microresearch/WORM/README.md

The WORM was for a long time desirous to speake, but the rule and
or∣der of the Court enjoyned him silence, but now strutting and
swelling, and impatient, of further delay, he broke out thus... [Maier]
