microresearch/WORM/worm001_revised_reducing003-SilkS_Front.pdf

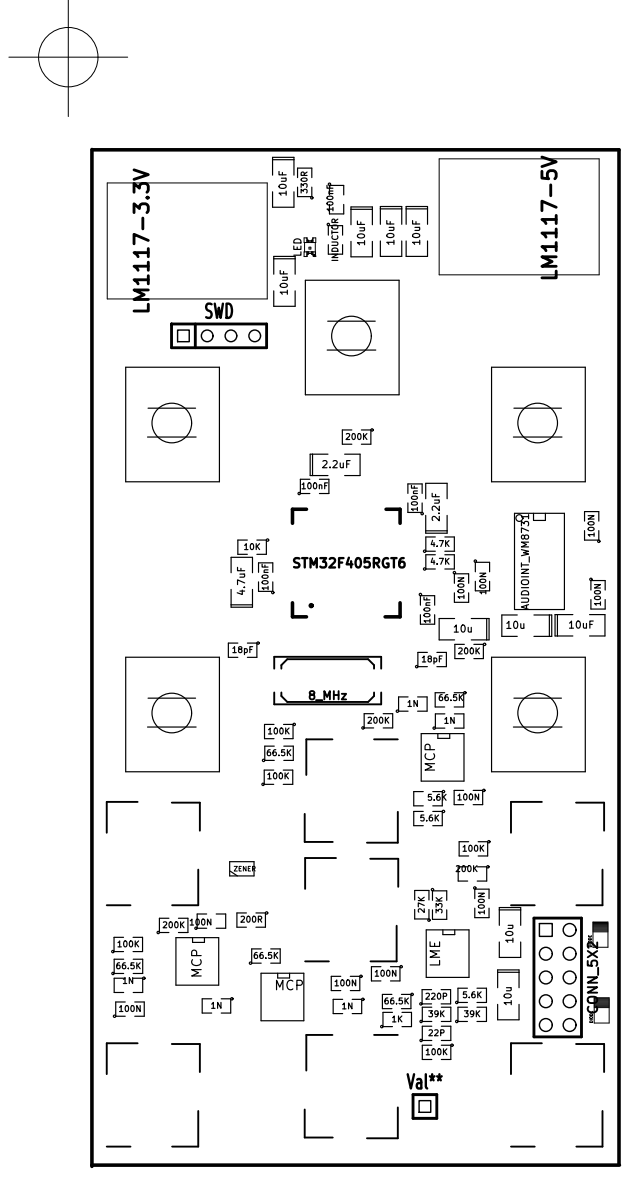
[picture p1: page 1]
