microresearch/WORM/worm001-Sheet550B4EA0.pdf

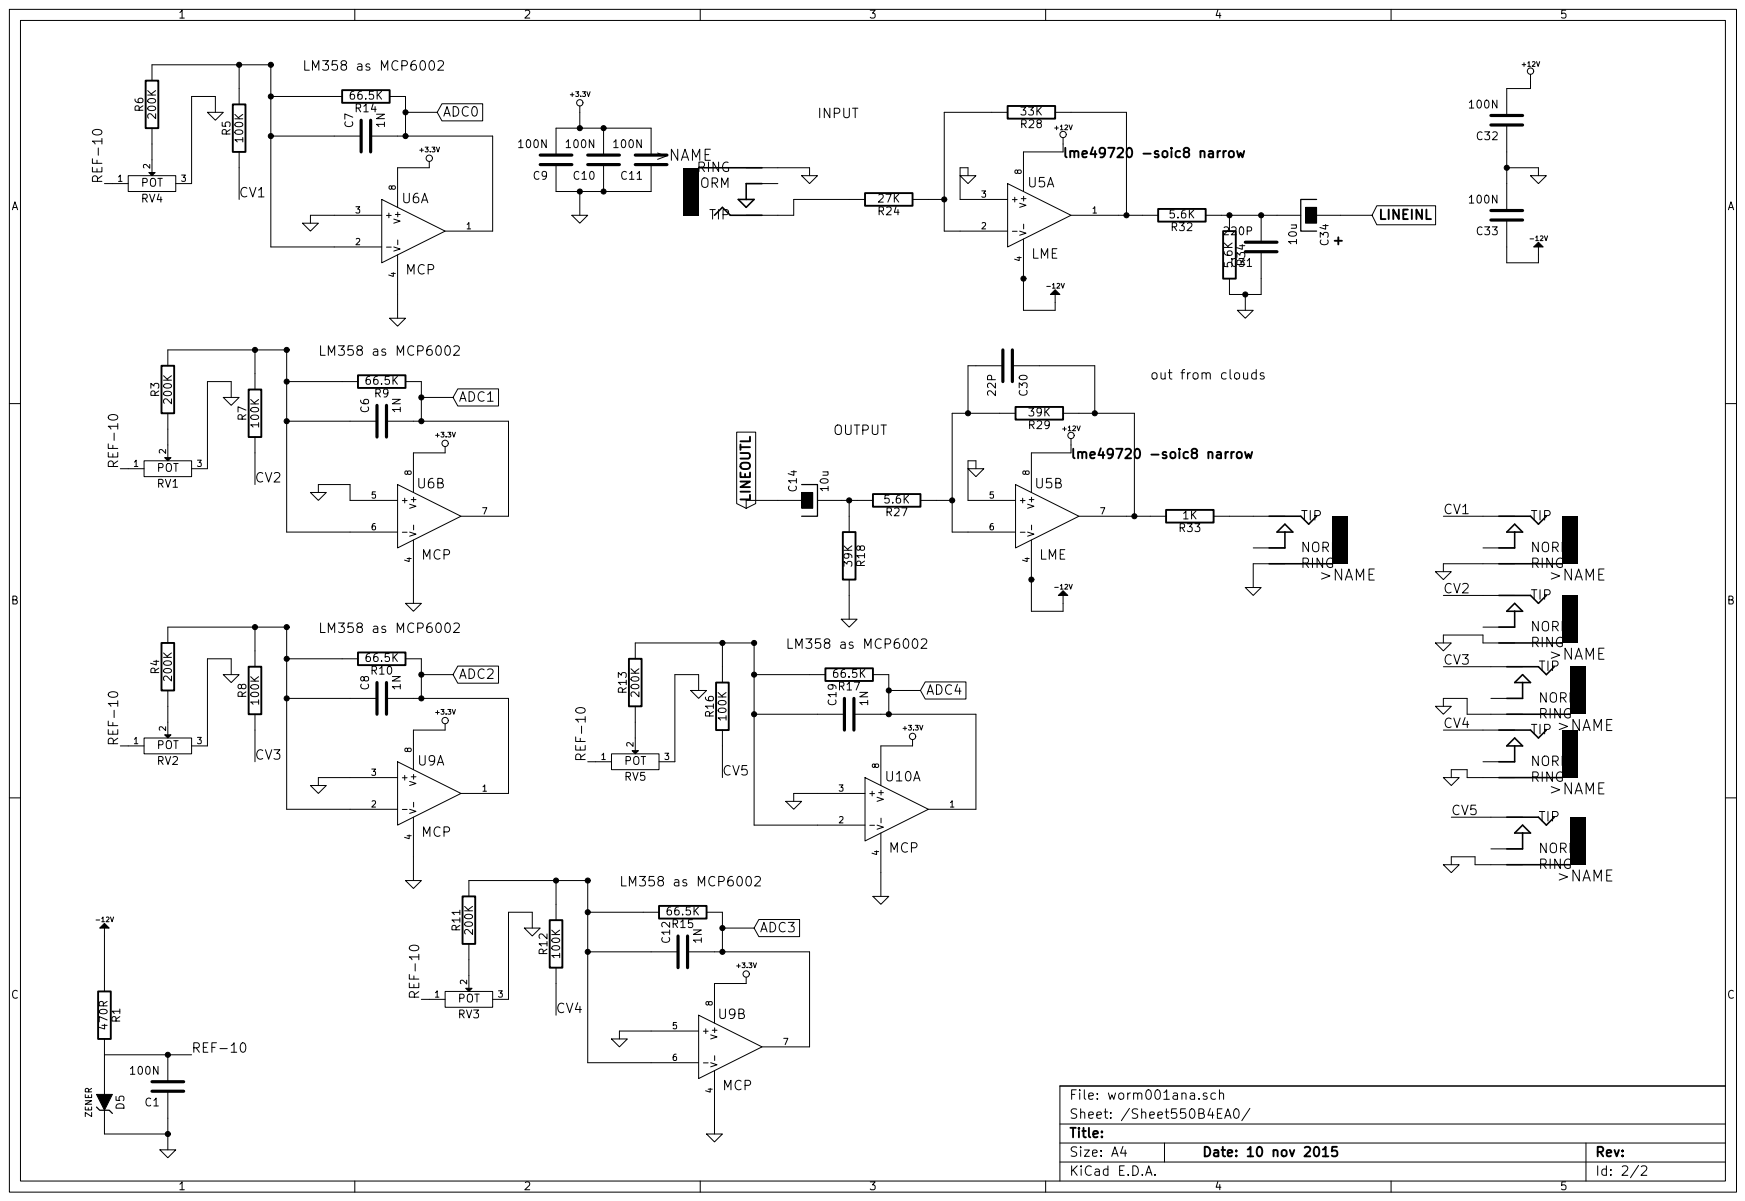
[picture p2: page 1]
