microresearch/WORM/revival/worm001.pdf

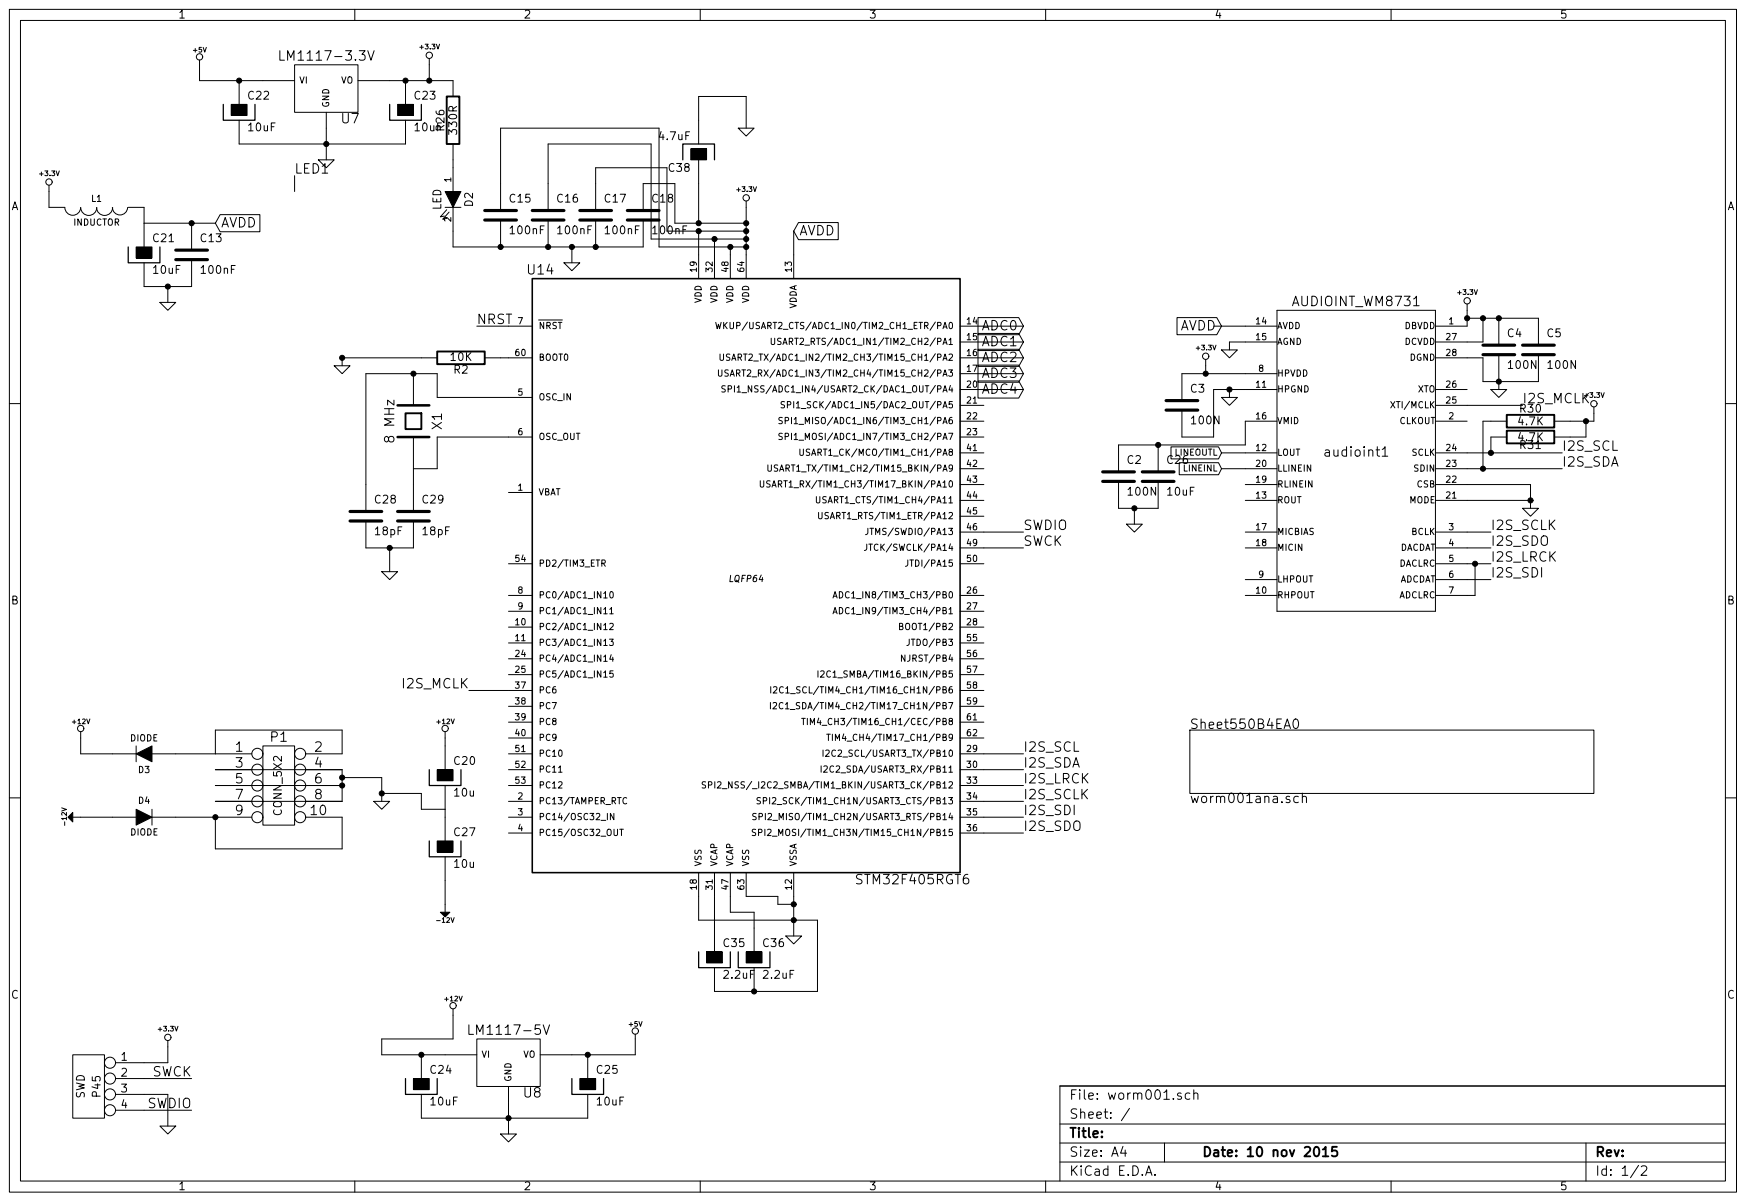
[picture p3: page 1]
