microresearch/WORM/revival/new_worm3.kicad_pcb

## KiCad design revival/new_worm3.kicad_pcb (2024-03-12)

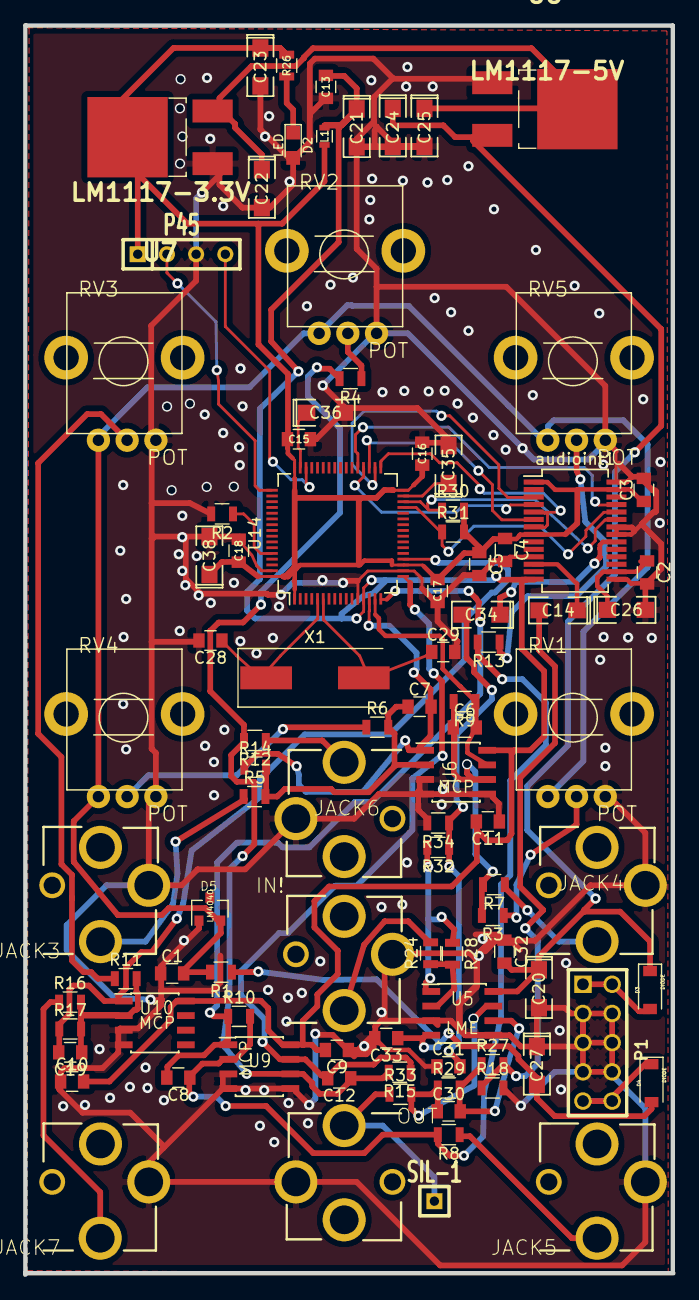
[picture p4: board new_worm3.kicad_pcb from above]

Board: 2 copper layers, 56.4 x 108.7 mm, 94 parts (0 on the bottom side), 55 nets.

Parts:
C1, C2, C3, C4, C5, C9, C10, C11, C32, C33: 100N; C_0805
C6, C7, C8, C12, C19: 1N; C_0805
C13, C15, C16, C17, C18: 100nF; C_0805
C14, C20, C27, C34: 10u; SMD-1206_Pol1.4mmnew
C21, C22, C23, C24, C25, C26: 10uF; SMD-1206_Pol1.4mmnew
C28, C29: 18pF; C_0805
C30: 22P; C_0805
C31: 220P; C_0805
C35, C36: 2.2uF; SMD-1206_Pol1.4mmnew
C38: 4.7uF; SMD-1206_Pol1.4mmnew
D2: LED; LED_0805
D3, D4: DIODE; D_SOD-123
D5: LM4040; SOT-23
IN!: AUDIO-JACKERTHENVAR_ERTHENVAR-JACK; ERTHENVAR-JACK
JACK3, JACK4, JACK5, JACK6, JACK7: AUDIO-JACKERTHENVAR_ERTHENVAR-JACK; ERTHENVAR-JACK
L1: INDUCTOR; L_0603
OUT: AUDIO-JACKERTHENVAR_ERTHENVAR-JACK; ERTHENVAR-JACK
P1: CONN_5X2; PIN_ARRAY_5x2
P45: SWD; SIL-4
R1: 200R; R_0805
R2: 10K; R_0805
R3, R4, R6, R11, R13: 200K; R_0805
R5, R7, R8, R12, R16: 100K; R_0805
R9, R10, R14, R15, R17: 66.5K; R_0805
R18, R29: 39K; R_0805
R24: 27K; R_0805
R26: 330R; R_0805
R27, R32, R34: 5.6K; R_0805
R28: 33K; R_0805
R30, R31: 4.7K; R_0805
R33: 1K; R_0805
RV1, RV2, RV3, RV4, RV5: POT; RV1
SIL-1: Val**; SIL-1
U5: LME; SOIC-8_3.9x4.9mm_Pitch1.27mm
U6, U9, U10: MCP; SOIC-8_3.9x4.9mm_Pitch1.27mm
U7: LM1117-3.3V; TO-252-2_Rectifier
U8: LM1117-5V; TO-252-2_Rectifier
U14: STM32F405RGT6; LQFP-64_10x10mm_Pitch0.5mm
X1: 8_MHz; Crystal_SMD_HC49-SD
audioint1: AUDIOINT_WM8731; SSOP-28_5.3x10.2mm_Pitch0.65mm

Connections:
+3.3V: C3.1, C4.1, C5.1, C15.1, C16.1, C17.1, C18.1, C23.1, C38.1, L1.2, P45.1, R26.2, R30.2, R31.2, U7.2, U14.1, U14.19, U14.32, U14.48, U14.64, audioint1.1, audioint1.8, audioint1.27
+5V: C22.1, C25.1, U7.3, U8.2
+12V: C20.1, C24.1, C32.2, D3.1, U5.8, U8.3
-12V: C27.2, C33.1, D4.2, R1.1, U5.4
/I2S_LRCK: U14.33, audioint1.5, audioint1.7
/I2S_MCLK: U14.37, audioint1.25
/I2S_SCL: R31.1, U14.29, audioint1.24
/I2S_SCLK: U14.34, audioint1.3
/I2S_SDA: R30.1, U14.30, audioint1.23
/I2S_SDI: U14.35, audioint1.6
/I2S_SDO: U14.36, audioint1.4
/SWCK: P45.2, U14.49
/SWDIO: P45.4, U14.46
/Sheet550B4EA0/CV1: JACK3.3, R5.1
/Sheet550B4EA0/CV2: JACK4.3, R7.1
/Sheet550B4EA0/CV3: JACK5.3, R8.1
/Sheet550B4EA0/CV4: JACK6.3, R12.1
/Sheet550B4EA0/CV5: JACK7.3, R16.1
/Sheet550B4EA0/REF-10: C1.2, D5.2, R1.2, RV1.1, RV2.1, RV3.1, RV4.1, RV5.1
ADC0: C7.2, R14.1, U6.1, U14.14
ADC1: C6.2, R9.1, U6.7, U14.15
ADC2: C8.2, R10.1, U9.1, U14.16
ADC3: C12.2, R15.1, U9.7, U14.17
ADC4: C19.2, R17.1, U10.1, U14.20
AVDD: C9.2, C10.2, C11.2, C13.1, C21.1, L1.1, U6.8, U9.8, U10.8, U14.13, audioint1.14
GND: C1.1, C2.2, C3.2, C4.2, C5.2, C9.1, C10.1, C11.1, C13.2, C15.2, C16.2, C17.2, C18.2, C20.2, C21.2, C22.2, C23.2, C24.2, C25.2, C26.2, C27.1, C28.2, C29.2, C31.1, C32.1, C33.2, C35.2, C36.2, C38.2, D2.2, D5.1, IN!.1@1, JACK3.1@1, JACK4.1@1, JACK5.1@1, JACK6.1@1, JACK7.1@1, OUT.1@1, P1.3, P1.4, P1.5, P1.6, P1.7, P1.8, P45.3, R2.2, R18.2, R34.2, RV1.3, RV2.3, RV3.3, RV4.3, RV5.3, U5.3, U5.5, U6.3, U6.4, U6.5, U7.1, U8.1, U9.3, U9.4, U9.5, U10.3, U10.4, U14.12, U14.18, U14.63, audioint1.11, audioint1.15, audioint1.21, audioint1.22, audioint1.28
LINEINL: C34.1, audioint1.20
LINEOUTL: C14.1, audioint1.12
unnamed: C2.1, C26.1, audioint1.16
unnamed: D2.1, R26.1
unnamed: R2.1, U14.60
unnamed: C28.1, U14.5, X1.1
unnamed: C36.1, U14.47
unnamed: C35.1, U14.31
unnamed: C29.1, U14.6, X1.2
unnamed: D4.1, P1.9, P1.10
unnamed: D3.2, P1.1, P1.2
unnamed: C8.1, R8.2, R10.2, R13.2, U9.2
unnamed: C19.1, R11.2, R16.2, R17.2, U10.2
unnamed: R3.1, RV1.2
unnamed: R4.1, RV2.2
unnamed: IN!.3, R24.2
unnamed: R13.1, RV5.2
unnamed: C12.1, R4.2, R12.2, R15.2, U9.6
unnamed: R11.1, RV3.2
unnamed: C31.2, C34.2, R32.1, R34.1
unnamed: R6.1, RV4.2
unnamed: C7.1, R5.2, R6.2, R14.2, U6.2
unnamed: R24.1, R28.2, U5.2
unnamed: OUT.3, R33.1, SIL-1.1
unnamed: C6.1, R3.2, R7.2, R9.2, U6.6
unnamed: C30.2, R27.1, R29.2, U5.6
unnamed: C14.2, R18.1, R27.2
unnamed: C30.1, R29.1, R33.2, U5.7
unnamed: R28.1, R32.2, U5.1
