microresearch/WORM/revival/worm001.sch

## KiCad design revival/worm001.sch (2015-11-10)

Schematic: worm001.sch

Parts:
C2, C3, C4, C5: 100N
C13, C15, C16, C17, C18: 100nF
C20, C27: 10u
C21, C22, C23, C24, C25, C26: 10uF
C28, C29: 18pF
C35, C36: 2.2uF
C38: 4.7uF
D2: LED
D3, D4: DIODE
L1: INDUCTOR
P1: CONN_5X2
P45: SWD
R2: 10K
R26: 330R
R30, R31: 4.7K
U7: LM1117-3.3V
U8: LM1117-5V
U14: STM32F405RGT6; LQFP64
X1: 8 MHz
audioint1: AUDIOINT_WM8731
