microresearch/WORM/revival/worm001ana.sch

## KiCad design revival/worm001ana.sch (2015-11-10)

Schematic: worm001ana.sch

Parts:
C1, C9, C10, C11, C32, C33: 100N
C6, C7, C8, C12, C19: 1N
C14, C34: 10u
C30: 22P
C31: 220P
D5: ZENER
JACK1, JACK2, JACK3, JACK4, JACK5, JACK6, JACK7: AUDIO-JACKERTHENVAR_ERTHENVAR-JACK
R1: 470R
R3, R4, R6, R11, R13: 200K
R5, R7, R8, R12, R16: 100K
R9, R10, R14, R15, R17: 66.5K
R18, R29: 39K
R24: 27K
R27, R32, R34: 5.6K
R28: 33K
R33: 1K
RV1, RV2, RV3, RV4, RV5: POT
U5: LME
U6, U9, U10: MCP

Notes on the sheet:
op amps fixed
OUTPUT
INPUT
out from clouds
LM358 as MCP6002
lme49720 -soic8 narrow
