microresearch/WORM/(commit log)

2015-11-02 adding basic schematic
    [worm001.brd, worm001.sch, worm001ana.sch]
2015-11-04 begin brd
    [worm001.brd]
2015-11-05 final checks brd
    [worm001.brd]
2015-11-24 define for board
2015-11-25 revised mirror of cv potis
    [worm001_revised.brd]
2016-05-28 size of panel and pcb redcued
    [worm001_panel_revised_reducing.brd, worm001_revised_reducing.brd]
2016-06-08 xxx - new pcb close to finished
    [worm001_panel_revised_reducing002.brd, worm001_revised_reducing002.brd]
2016-06-09 new 003 brd
    [worm001_revised_reducing003.brd]
2016-06-16 sp0256 tests working almost
    [worm001_panel_revised_reducing002.brd, worm001_revised_reducing003.brd]
2016-06-23 lm4040 change resistor
    [worm001_revised_reducing003.brd]
2016-10-18 adc fixings
2016-12-18 added tubeset
2017-03-06 x220 1v/oct
2021-06-15 bom and co.
2022-02-26 WORM revival
    [new_worm3.kicad_pcb, worm001.brd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]
2022-03-30 new worm pcb
    [new_worm3.csv, new_worm3.kicad_pcb, new_worm3_panel.kicad_pcb]
